ut-robotics/picr21-team-kurgimopeed/config/calibration_source_example.png

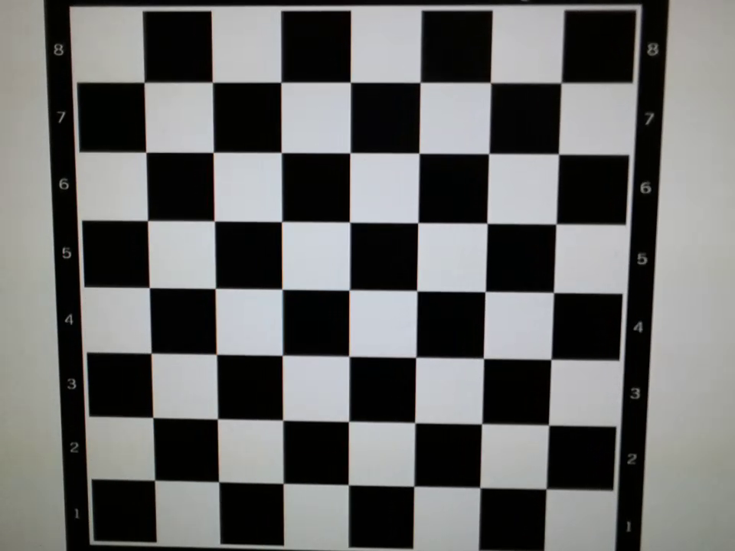
config/calibration_source_example.png
