ut-robotics/picr21-team-kurgimopeed/config/calibration_source.png

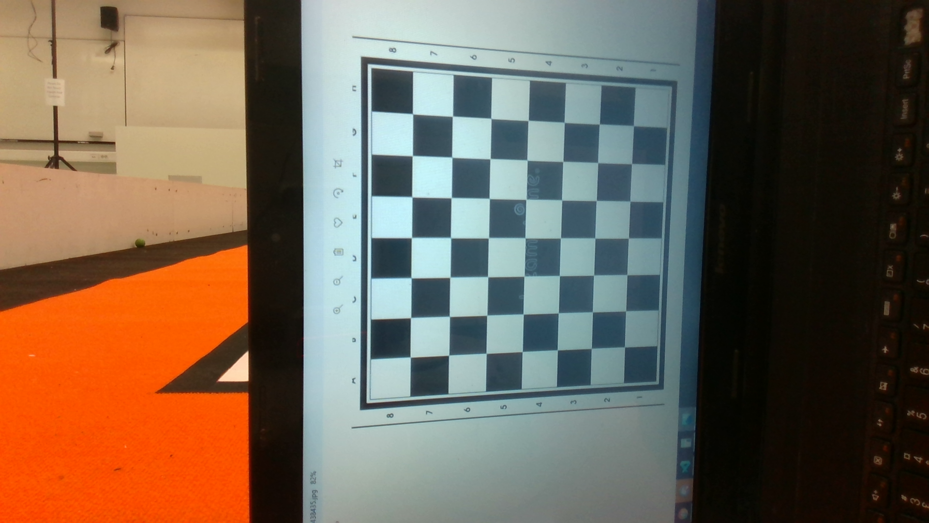
config/calibration_source.png
