ut-robotics/picr21-team-kurgimopeed/README.md

# picr21-team-kurgimopeed

## Usage

`sudo uvicorn app:app --port 5000` - start admin web view (in backend dir). port is configured in `/etc/nginx/nginx.conf`. root is required for led drivers and realsense (nice arch plugdev)
