ut-robotics/picr21-team-kurgimopeed/electronics/3dmodels/B1047AS-4R7N=P3.step

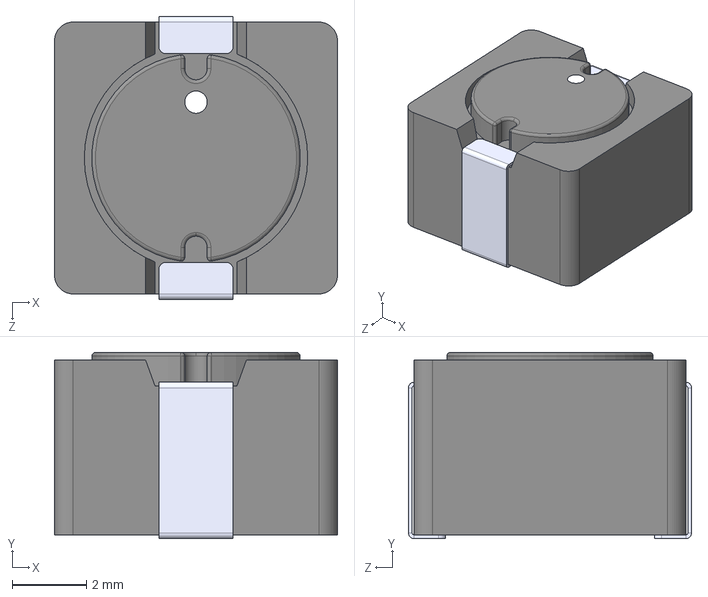
[picture p3: CAD file, 2021-11-22]
electronics/3dmodels/B1047AS-4R7N=P3.step
7.60 x 5.00 x 7.60 mm
