ut-robotics/picr21-team-kurgimopeed/electronics/graphics/pcb_inner.dxf

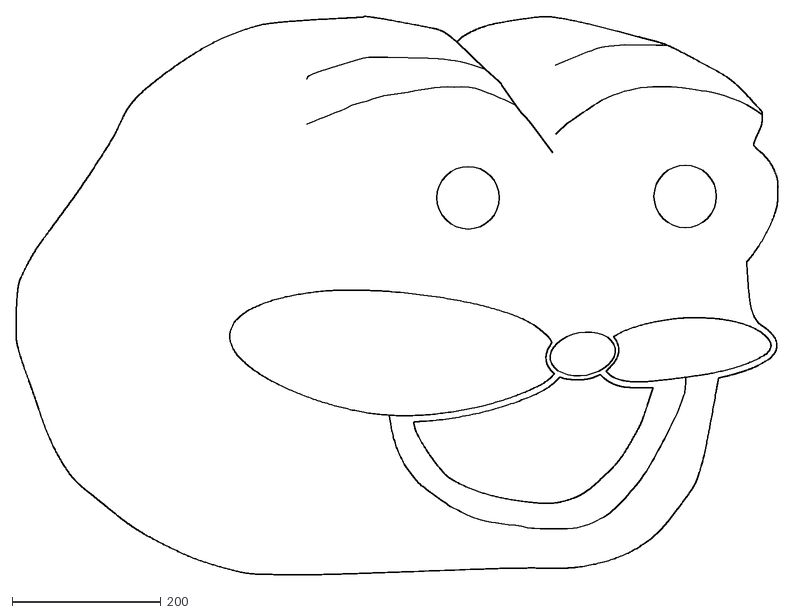
[picture p4: CAD file, 2021-11-01]
electronics/graphics/pcb_inner.dxf
1023.8 x 750.3
