ut-robotics/picr21-team-kurgimopeed/electronics/3dmodels/FTSH-105-XX-X-DV.step

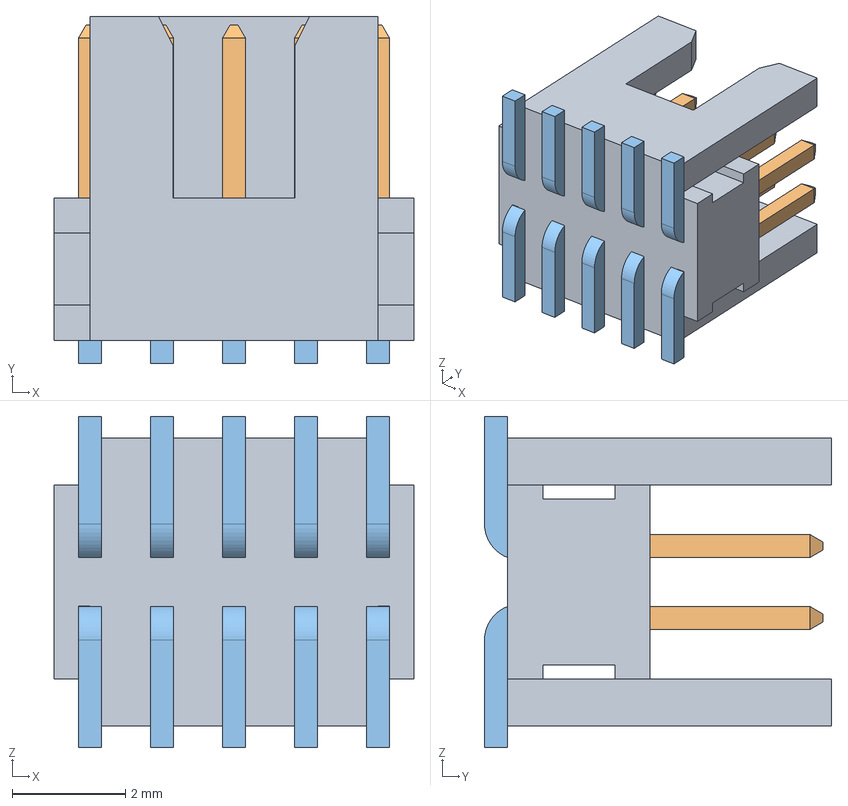
[picture p5: CAD file, 2021-11-01]
electronics/3dmodels/FTSH-105-XX-X-DV.step
6.35 x 6.12 x 5.84 mm
_FTSH-105-01-L-DV-K_body
_FTSH-105-01-L-DV-K_pins1
_FTSH-105-01-L-DV-K_pins2
