ut-robotics/picr21-team-kurgimopeed/electronics/graphics/pcb_outer.dxf

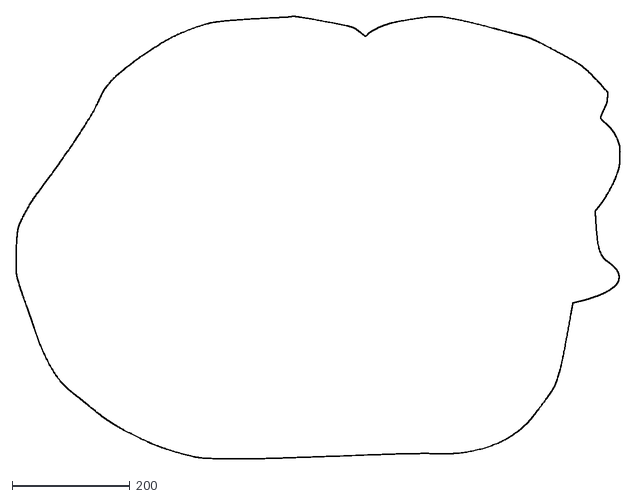
[picture p6: CAD file, 2021-11-01]
electronics/graphics/pcb_outer.dxf
1023.8 x 750.3
