ut-robotics/picr21-team-kurgimopeed/electronics/3dmodels/215079-4.step

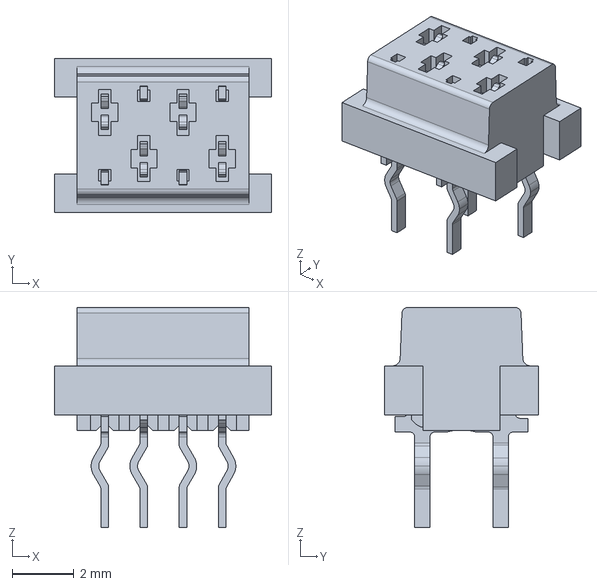
[picture p7: CAD file, 2021-11-01]
electronics/3dmodels/215079-4.step
7.04 x 5.00 x 7.15 mm
