ut-robotics/picr21-team-kurgimopeed/(threads)

Thread 1 (2021-09-27):

[Mechanics] - wrong material thickness

Akustav, 2021-09-27:
Material thickness for a 5mm PC sheet is actually 4.8mm

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

Closed 2021-10-02.

Thread 5 (2021-09-27):

[Mechanics] - pieces seem overdimensioned

Akustav, 2021-09-27:
The sidewalls seem unneeded large and don't appear to add anything. Maybe this part can be skipped?
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

Additionally the small ramps can maybe optimized? For example we can remove 2 of the 4 holes:
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

To get some additional support for the ramp, you can extend it below a little and make it rest on top of the chassis. Something like this:

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

Closed 2021-10-02.

Thread 7 (2021-10-07):

[Mechanics] - current feedrates too large

Akustav, 2021-10-07:
I think the current state of the mill does not allow for 1000mm/min feedrates. I would suggest at most 800mm. You can also reduce RPM to around 16000 in this case.

Closed 2021-10-10.

Thread 8 (2021-10-16):

Serial port is hardcoded

ReikoR, 2021-10-16:
https://github.com/ut-robotics/picr21-team-kurgimopeed/blob/785dc52e1931ac47d1d2bba7f9e51507c58a011b/backend/app.py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

Consider using [serial.tools.list_ports](https://pyserial.readthedocs.io/en/latest/tools.html#module-serial.tools.list_ports) to find correct USB device based on the port info values.

Thread 16 (2021-10-29):

[Mechanics] - Omniwheel roller extrusions should not cover the whole wheel

Akustav, 2021-10-29:
The extruded part locating the rollers should not touch anything but the internal part of the bearing. You would need to make a cut (red) and everything after that should be flat and further away from the rollers (blue)

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

Otherwise you can also use a conical extrusion similar to this:
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

Akustav, 2021-11-06:
Reopening. I would also remove these parts. They can touch the moving part of the bearing.
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

MattiasAvi, 2021-11-07:
Fixed This issue

Closed 2021-11-07.

Thread 18 (2021-10-29):

[Mechanics] - wheel patterning improvement

Akustav, 2021-10-29:
This is not an issue but more of an suggestion:

You do not need to pattern only sketches but can also pattern extrusions, cuts, chamfers or any other operations. This helps to simplify editing the model in certain situations.

MattiasAvi, 2021-10-30:
Very useful advice

Closed 2021-10-30.

Thread 20 (2021-10-29):

[Mechanics] - how the wheel should be placed in the robot

Akustav, 2021-10-29:
A question regarding how the wheel will fit into the whole assembly. Do you plan to cover the wheel?

This is important because currently rollers and bolts holding the wheel together can damage parts of the field (baskets) and opponents when they are grazed by the spinning wheel.

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

Closed 2021-10-30.

Thread 23 (2021-11-07):

Keep isolated parts completely separate

ReikoR, 2021-11-07:
Encoder connectors are placed on the drivers side, but are connected to MCU side. For better isolation (and signal integrity) the encoder signals should be kept on the MCU side.

All signals and power should be kept separate without any overlap and the gap between the isolated sides should be made larger.

Closed 2021-11-17.

Thread 24 (2021-11-07):

Use solid grounds on inner layers

ReikoR, 2021-11-07:
Try to use inner layers only for ground and outer layers for signals and power.

Recommended stackup:
1. Signals and power
2. GND (reference plane for layer 1)
3. GND (reference plane for layer 4)
4. Signals and power

Return current travels on the reference plane along the path of least impedance (as straight as possible in case of DC and under  the signal in case of higher speed signals).

When there are gaps in the reference plane the return current has to travel around the gaps. This will cause the electromagnetic fields to spread out and may cause signal integrity problems.

Some more info:
https://www.protoexpress.com/blog/current-return-path-signal-integrity/

Closed 2021-11-17.

Thread 25 (2021-11-07):

Use power inductor for switching regulator

ReikoR, 2021-11-07:
Switching regulator inductor (L1) should be rated for at least few amps and preferably with low DCR to reduce losses.

Closed 2021-11-17.

Thread 26 (2021-11-17):

Connect GND with vias close to the component

ReikoR, 2021-11-17:
When vias are farther away from the component, the current return path is farther away from the current supply path and larger current loop will create more crosstalk.

Component GND should be connected to the GND plane with vias as close as possible to GND pad. Multiple GND vias help to reduce the inductance. It's fine to put vias in pads when the components are hand soldered.

The return current should flow as close as possible to supply current.

GND copper zones on top and bottom layers are probably not needed at all, but might help with heat dissipations. GND vias in driver's GND pad help with heat dissipation.

Red lines show the current flow on the board right now and green lines show how it could be improved. Components should probably be moved a bit to help with routing and current loops.

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

ReikoR, 2021-11-19:
There are still several places where vias should be placed close to the components.

Some of them:
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

Closed 2021-11-21.

Thread 27 (2021-11-17):

Keep tracks above reference plane

ReikoR, 2021-11-17:
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

Tracks should be above the reference planes (GND in this case) to avoid electromagnetic fields from spreading out and causing crosstalk.

It would also be better if the tracks were not at the edge of the plane, but more inside the plane area.

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

Closed 2021-11-19.

Thread 28 (2021-11-17):

Follow switching regulator layout guidelines in the datasheet

ReikoR, 2021-11-17:
[TPS54227 datasheet](https://www.ti.com/lit/ds/symlink/tps54227.pdf)

For example SW node could be shorter and wider.

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

From datasheet:
> **10 Layout**
> **10.1 Layout Guidelines**
> 2\. Keep the SW node as physically small and short as possible to minimize parasitic capacitance and
inductance and to minimize radiated emissions. Kelvin connections should be brought from the output to the
feedback pin of the device
> 13\. PCB pattern for VIN, SW, and PGND should be as broad as possible.

Closed 2021-11-19.

Thread 29 (2021-11-17):

Add capacitor to NRST pin

ReikoR, 2021-11-17:
Recommendations from [STM32G441KB datasheet](https://www.st.com/resource/en/datasheet/stm32g441kb.pdf)
5.3.15 NRST pin characteristics
Figure 27. Recommended NRST pin protection
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

Switch on the drawing is optional.

> 1\. The reset network protects the device against parasitic resets.
> 3\. The external capacitor on NRST must be placed as close as possible to the device.

Closed 2021-11-19.

Thread 30 (2021-11-17):

Use larger annual ring for vias

ReikoR, 2021-11-17:
[JLCPCB capabilities](https://jlcpcb.com/capabilities/Capabilities) lists minimum annual ring as 0.13mm.

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

Currently vias are 0.3/0.5 mm size.

It's better to use 0.3/0.6 mm size.
0.2/0.45 mm is the smallest size that can be used if smaller vias are needed.

Closed 2021-11-19.

Thread 33 (2021-12-11):

Separate code more

ReikoR, 2021-12-11:
Right now `ImageProcess` class is inheriting `RSCamera` class and internally using `DrivingLogic` class instance. It would be better to clearly separate different classes so that they can function independently.

Generic example on how to keep different classes separate:
```python
class RobotController:
    def run(self):
        while not self.is_stopped:
            rgb_image = self.camera.get_rgb_image()
            objects = self.image_processor.find_objects(rgb_image) # returns balls, baskets
            motor_speeds = self.driving_logic.run_logic(objects)
            self.motor_driver.set_speeds(motor_speeds)
```

Above code is only partially based on existing code and omits a lot of functionality, but should give a general idea.

joshmmst, 2021-12-16:
hello
, we did some big changes in f58cd061d8bf84e7fb61010434024d1e80bd4f52. Everything should be O.K! Also added referee client.

joshmmst, 2021-12-16:
we kept motor driver on separate core with multiprocessing and referee server creates an event loop thread but rest is one thread pipeline. please do check RobotController class

ReikoR, 2021-12-17:
https://github.com/ut-robotics/picr21-team-kurgimopeed/blob/8249a71791fdd2d88afe97c632eb1babe7b56f4a/backend/src/RobotController.py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

https://github.com/ut-robotics/picr21-team-kurgimopeed/blob/8249a71791fdd2d88afe97c632eb1babe7b56f4a/backend/src/DrivingLogic.py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

You are also instantiating `RefereeClient` in `DrivingLogic`, but it's not used there.

jakoai, 2021-12-18:
Removen RefereeClient from DrivingLogic

Closed 2021-12-18.

Thread 34 (2021-12-13):

[Mechanics] - camera should point a little more down.

Akustav, 2021-12-13:
You would want an angle more like this:

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

The advantage here is that you see the ball until the last possible moment. Additionally you do not see spectators and whatever noise might come from there.

MattiasAvi, 2021-12-14:
Redesigned entire camera stand.

Closed 2021-12-14.

Thread 35 (2021-12-13):

[Mechanics] - thrower angle adjust could use previous iteration

Akustav, 2021-12-13:
I would change the thrower angle-adjust a little. I would make it so that the movement of the internal ramp is guided by a separate arm that extends from the center of the ramp (also the center of the motor), like this:

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

Such a system allows for a very smoothly moving internal ramp. Do you have a motor with a shaft?

Additionally the simplest angle adjust would be something like this:
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

Where the blue piece has a slot in it that goes into a pin that is attached to the moving ramp. If you move the servo up-down then the pin slides in this slot and allows the ramp to move either up or down.

Akustav, 2021-12-13:
You can also look at how the servo arm was used in conjunction with the blue piece.

Akustav, 2021-12-14:
Additionally it is unclear how stuff attaches to the servo since the servo horn is not in the model.

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

Akustav, 2021-12-21:
I would also beef up the arm. It should bend as little as possible while throwing:

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

MattiasAvi, 2021-12-21:
Made this part bulkier.

Akustav, 2021-12-21:
How do you plan to assemble it? I would make it so that you fasten the arm to the servo horn and then screw this assembly to the servo. Currently you need to do the final assembly with the servo attached that can make it more difficult.

I would have a central hole in the arm that lets you attach and remove the assembly simply.

MattiasAvi, 2021-12-21:
Thanks for this suggestion. It would have been quite annoying to assemble it. Made a hole in the center.

Closed 2021-12-22.

Thread 36 (2021-12-13):

[Mechanics] - move thrower into the robot

Akustav, 2021-12-13:
Currently the thower allows to pull a ball in from quite far off the sides:

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

This can create an issue with accuracy since it can be pulled through the thrower at an angle (red arrow).

You can do multiple things to mitigate it:
* move thrower inside so the sidewalls guide and center the ball
* Have a tight front end with a grabbing mechanism that centers the ball
* Have a slimmer front-end overall and hope programmers to a good job

MattiasAvi, 2021-12-14:
Moved robot thrower into the robot. Can't move any more because then PCB won't fit.

Closed 2021-12-14.

Thread 37 (2021-12-13):

[Mechanics] - how are internal ramp components attached?

Akustav, 2021-12-13:
How are these pieces attached to eachother?

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

MattiasAvi, 2021-12-14:
Stationary parts are attached with bolts and spacers. Do we have any long rods at least 65 mm of length in Delta? Preferably around 3 mm diameter.

Akustav, 2021-12-14:
I dont think we have such a rod. Why not use spacers instead? Would make assembly simpler and more robust. Additionally, why have the slot instead of 2 holes?

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

MattiasAvi, 2021-12-21:
I am going to use hex standoffs for spacing. Most spaces are multiples of 5.

Akustav, 2021-12-21:
OK

Closed 2021-12-21.

Thread 38 (2021-12-13):

[Mechanics] - button and power lead input out of spec

Akustav, 2021-12-13:
The power input for the computer and the switch ports are out of spec:

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

Their requirements can be found here: https://digilabor.ut.ee/index.php/Basketball_robot_mechanics_design#PC_power_adapter_socket

Additionally, your camera mount blocks the hole to the power socket.

MattiasAvi, 2021-12-14:
Switch and button holes should fit specifications. Left some room at shorter ends of switch to fit it in better.

Akustav, 2021-12-14:
You left space here? The Length is 32 mm
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

Closed 2021-12-21.

Thread 39 (2021-12-13):

[Mechanics] - what is the purpose of additional motor supports

Akustav, 2021-12-13:
What is the purpose of these components?

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

They can make assembly/disassembly difficult. How are these components attached to each other, i see a hole for both of them, is this used?

MattiasAvi, 2021-12-14:
Removed additional motor supports.

Closed 2021-12-14.

Thread 40 (2021-12-13):

[Mechanics] - no batteries on model

Akustav, 2021-12-13:
Power delivery components missing:
* Batteries
* Battery mounting mechanism
* Power cables from Batteries
* Cable holes for other components, like camera, mainboard

MattiasAvi, 2021-12-14:
Batteries are now on the robot and are attached with hook and loop fasteners.

Akustav, 2021-12-14:
Just a note, I think you attached the batteries bottom side up.

Closed 2021-12-14.

Thread 41 (2021-12-13):

[Mechanics] - RGB sensor of camera not in middle of robot

Akustav, 2021-12-13:
Is this designed as intended? Usually this makes programming more difficult since you now need to perspective correct the aim of the robot.

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

MattiasAvi, 2021-12-14:
Moved RGB sensor to the middle.

Akustav, 2021-12-14:
The FOV cone is currently not attached to the RGB sensor, FYI:

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

MattiasAvi, 2021-12-14:
Changed the origin of FOV to RGB camera

Closed 2021-12-21.

Thread 42 (2021-12-13):

[Mechanics] - ramps can bend under load

Akustav, 2021-12-13:
Nothing connects the internal ramp and it can bend:

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

A very similar issue can gappen with the bottom ramp parts. They can bend and change throwing characteristics:

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

I would connect them with a spacer at their ends. For the front one i would also make it a little shorter so it does not hit the ball before the motor.

Closed 2021-12-14.

Thread 43 (2021-12-14):

[Mechanics] - roller design questions

Akustav, 2021-12-14:
Why is the roller asymmetrical? Based on my experience it has no big benefit compared to a normal round one since the ball has a rubbery texture and will stick to most surfaces.

I would suggest something similar to this:

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

This has the advantage of being simple to attach and remove, the servo horn should not be too much in the way. Additionally I would suggest making the whole roller girthier, to increase its strength. You might ram things with it.

MattiasAvi, 2021-12-21:
I found asymmetrical design from one of the thrower design examples. But your idea seems much better and I made something similar.

Akustav, 2021-12-21:
It is true that I have experimented with the asymmetrical design. It did not bring any tangible benefits compared to a round and symmetrical design.

Closed 2021-12-21.

Thread 44 (2021-12-14):

[Mechanics] - servo mounting holes missing

Akustav, 2021-12-14:
The servos do not currently have mounting holes

MattiasAvi, 2021-12-21:
Now all servos have mounting holes. I am going to use M3 bolts to keep servos still. It will work if I don't use rubber things that come with Corona servos.

Closed 2021-12-21.

Thread 45 (2021-12-21):

[Mechanics] - no fasteners on the thower

Akustav, 2021-12-21:
I think you should add some fastening holes for the thrower into the bottom plate:

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

MattiasAvi, 2021-12-21:
Added 4 holes to fasten the thrower. Is it enough or should I find a way to fasten thrower to upper plate also_

Akustav, 2021-12-21:
I think it is fine

Closed 2021-12-21.

Thread 46 (2021-12-21):

[Mechanics] - electronics board interference with motor encoder caps

Akustav, 2021-12-21:
The encoder caps and the electronics board intersect:

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

MattiasAvi, 2021-12-21:
Draw more precise PCB shape and now there\s no interference.

Akustav, 2021-12-21:
I think you can not place the board on the bottom flat since it has headers that go through the board. Also if it lifts this might be an issue:
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

MattiasAvi, 2021-12-21:
This should not be an issue because our robot's encoders are stripped from the case and in reality are quite smaller.

Akustav, 2021-12-22:
If you say so

Closed 2021-12-22.

Thread 48 (2021-12-28):

[Mechanics] - weird order of operations

Akustav, 2021-12-28:
Why is the last operation a slot? It might rip the piece off the substrate since it is held on just by tabs:

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

Akustav, 2021-12-28:
Similar issue is with the 2DContour2, where too much is in one operation. It might mille the OD out first, then does the internal slot, that might break off:

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

MattiasAvi, 2021-12-28:
> Why is the last operation a slot? It might rip the piece off the substrate since it is held on just by tabs:
>
> 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

My bad. Forgot to move it up. Managed to merge this contour with another and use 3 mm mill.

MattiasAvi, 2021-12-28:
> Similar issue is with the 2DContour2, where too much is in one operation. It might mille the OD out first, then does the internal slot, that might break off:
>
> 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

By changing some parameters I was able to get rid of the center slot. Now there are no tabs needed.

Closed 2021-12-29.

Thread 49 (2021-12-28):

[Mechanics] - increase object spacing

Akustav, 2021-12-28:
Currently the spacing between objects in 3.5 mm. This makes some objects be too close together. I would increase it to around 5

MattiasAvi, 2021-12-28:
Increased all spacings to 5 mm.

Closed 2021-12-29.

Thread 50 (2021-12-29):

[Mechanics] - remove stock to leave

Akustav, 2021-12-29:
You currently set the stock to leave property in some of the operations. This has a side effect of things not fitting together since slots, for example, are 0.2mm tighter:

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

Akustav, 2021-12-29:
This might re-create the unneeded tab issue.

MattiasAvi, 2021-12-30:
Removed "Stock to leave" in tight spaces. Some warnings reappeared but shouldn't be a problem.

Closed 2021-12-31.

Thread 51 (2021-12-29):

[Mechanics] - issue with stock size

Akustav, 2021-12-29:
Currently you have 2 components that are 5 mm instead of 4.8mm. To minimize changes i would suggest changing the top offset to -0.2 mm:

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

MattiasAvi, 2021-12-30:
Changed width of those details and issue is fixed.

Closed 2021-12-31.
