ut-robotics/picr21-team-kurgimopeed/electronics/output/Electronics.pdf

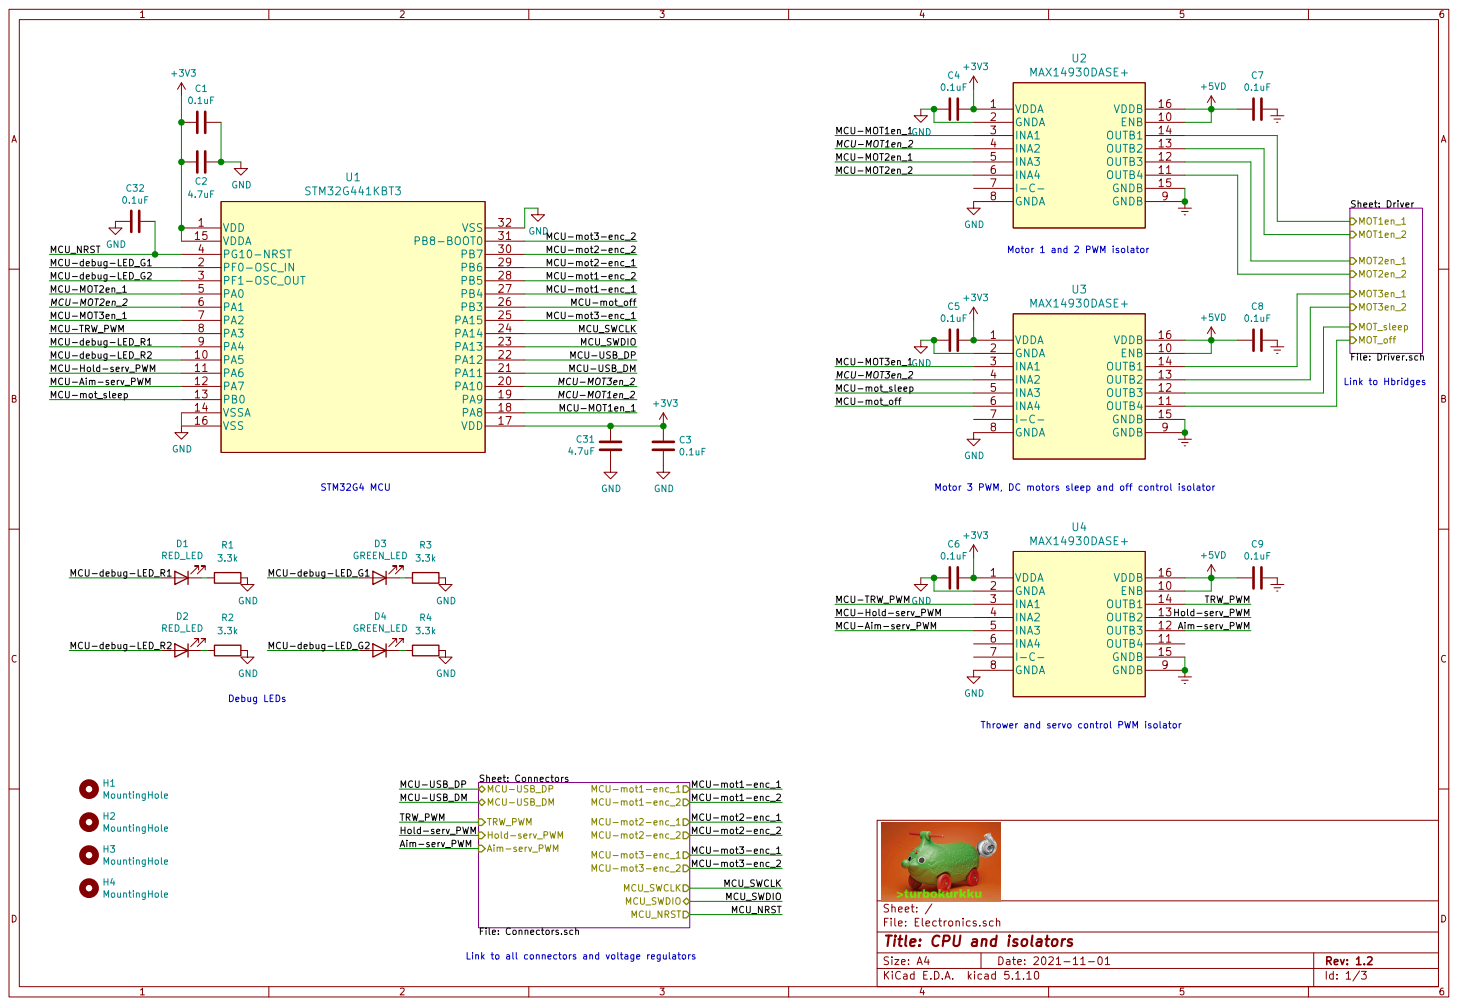
[picture p8: page 1]

MCU-debug-LED_R1 MCU-Hold-serv_PWM
MCU-Aim-serv_PWM

Link to Hbridges Thrower and servo control PWM isolator Motor 3 PWM, DC motors sleep and off control isolator Motor 1 and 2 PWM isolator

File: Electronics.sch Sheet: /
Id: 1/3 Title: CPU and isolators

Link to all connectors and voltage regulators

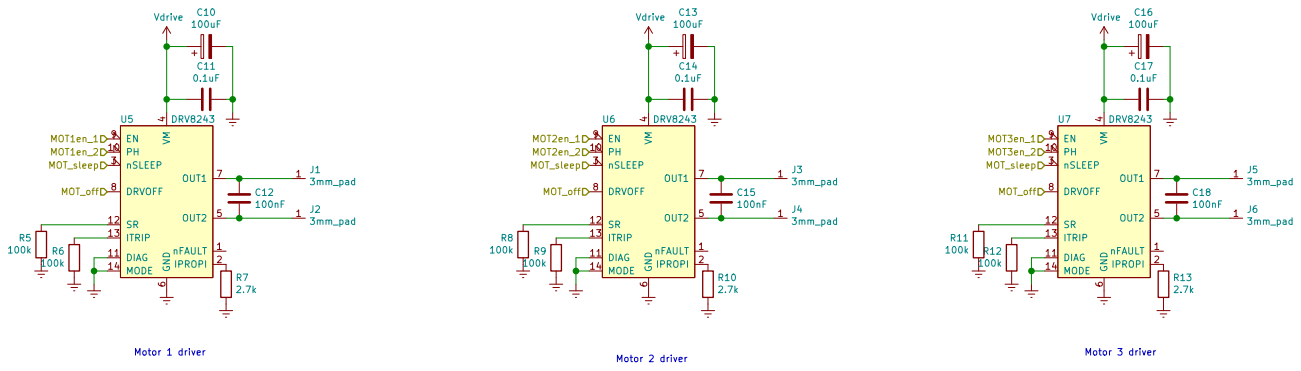
[picture p9: page 2]

6 OUT1 7 DRVOFF 8 EN 9 U7 DRV8243 Vdrive Vdrive C12

Id: 2/3 Title: Kurkkumopo HBridge driver File: Driver.sch Sheet: /Driver/

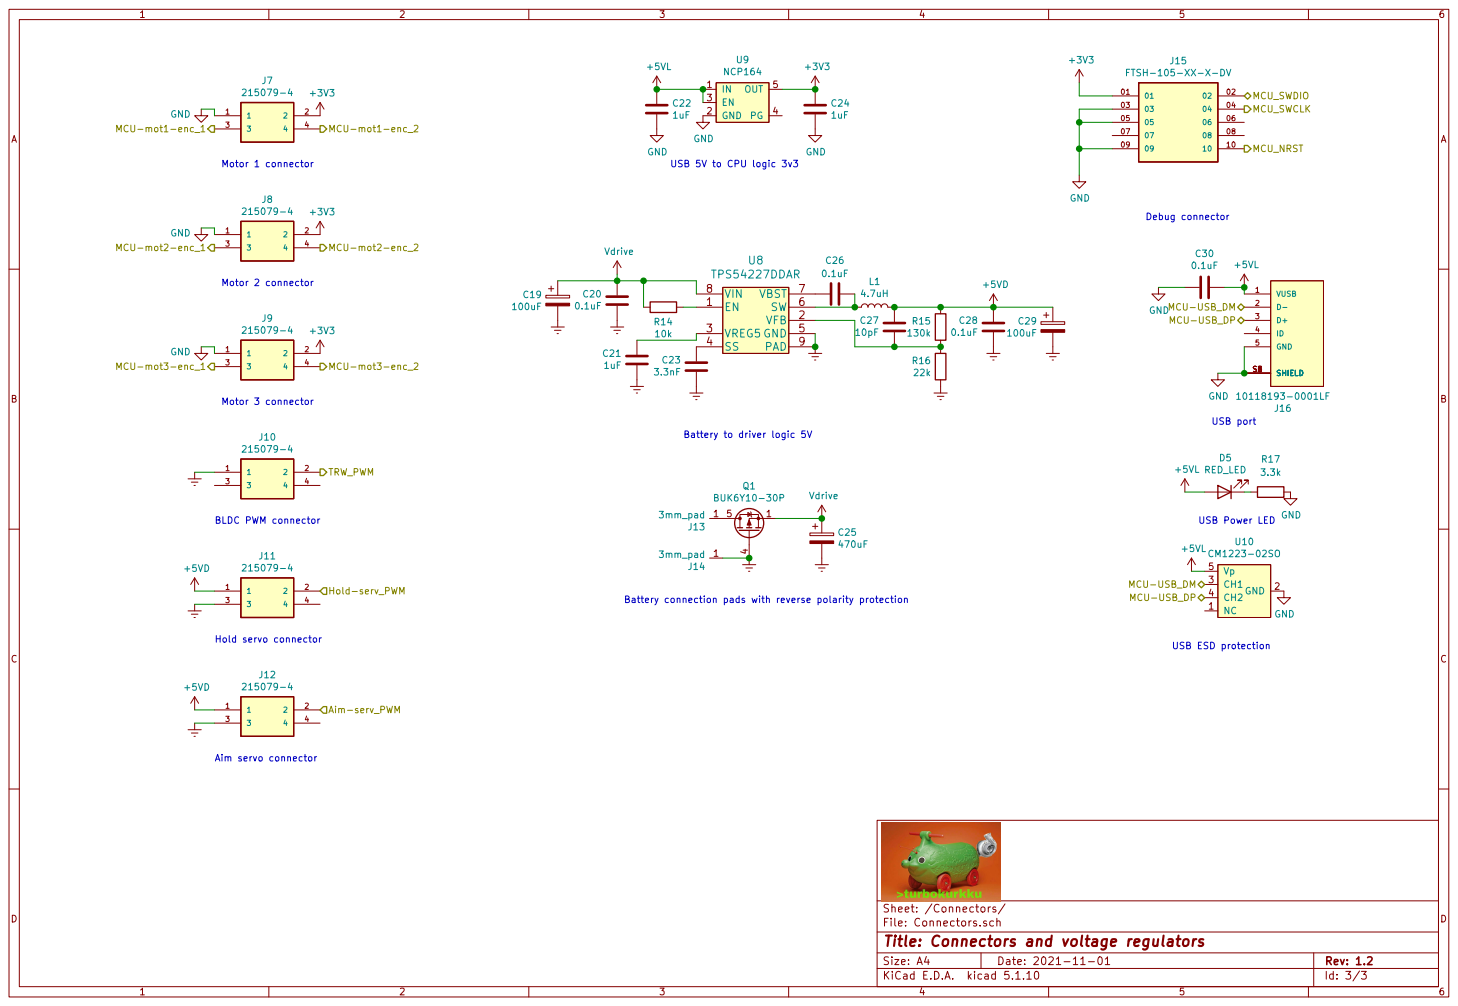
[picture p10: page 3]

Battery connection pads with reverse polarity protection

File: Connectors.sch Sheet: /Connectors/
Id: 3/3 Title: Connectors and voltage regulators
