ut-robotics/picr21-team-kurgimopeed/electronics/Electronics.kicad_pcb

## KiCad design electronics/Electronics.kicad_pcb (2021-11-22)

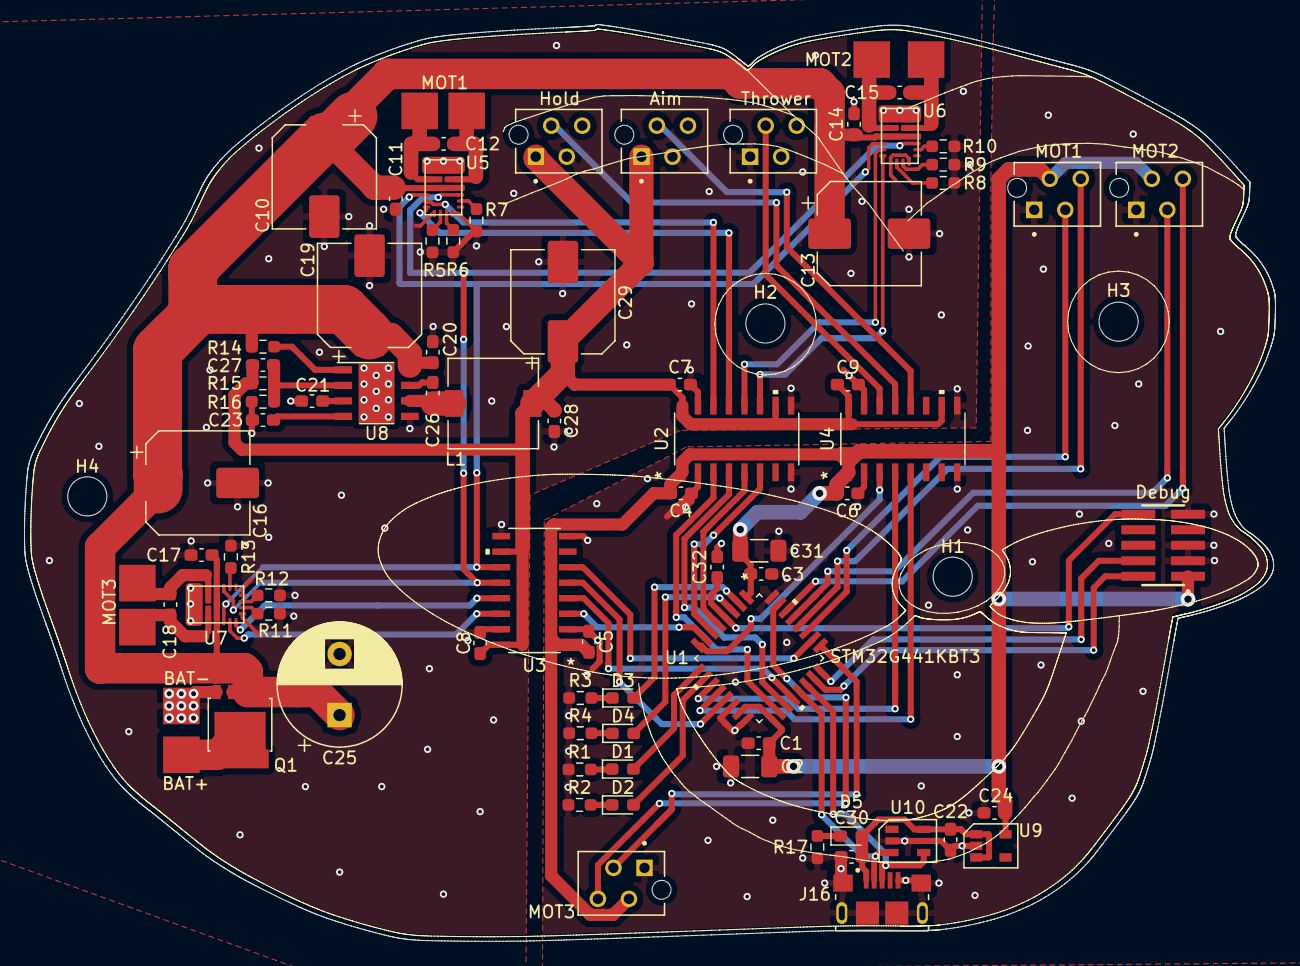
[picture p11: board Electronics.kicad_pcb from above]

Board: 4 copper layers, 102.4 x 75.0 mm, 86 parts (0 on the bottom side), 70 nets.

Parts:
Aim: 215079-4; TE_215079-4
BAT+: 3mm_pad
BAT-: 3mm_pad
C1, C3, C4, C5, C6, C7, C8, C9, C11, C14, C17, C20, C26, C28, C30, C32: 0.1uF; C_0603_1608Metric_Pad1.08x0.95mm_HandSolder
C2, C31: 4.7uF; C_1206_3216Metric_Pad1.33x1.80mm_HandSolder
C10, C13, C16, C19, C29: 100uF; CP_Elec_8x10
C12, C15, C18: 100nF; C_0603_1608Metric_Pad1.08x0.95mm_HandSolder
C21, C22, C24: 1uF; C_0603_1608Metric_Pad1.08x0.95mm_HandSolder
C23: 3.3nF; C_0603_1608Metric_Pad1.08x0.95mm_HandSolder
C25: 470uF; CP_Radial_D10.0mm_P5.00mm
C27: 10pF; C_0603_1608Metric_Pad1.08x0.95mm_HandSolder
D1, D2: RED_LED; LED_0603_1608Metric_Pad1.05x0.95mm_HandSolder
D3, D4: GREEN_LED; LED_0603_1608Metric_Pad1.05x0.95mm_HandSolder
D5: RED_LED; D_0603_1608Metric_Pad1.05x0.95mm_HandSolder
Debug: FTSH-105-XX-X-DV; SAMTEC_FTSH-105-XX-X-DV
H1, H2, H3, H4: MountingHole; MountingHole_3.2mm_M3
Hold: 215079-4; TE_215079-4
J2, J4, J5: 3mm_pad
J16: 10118193-0001LF; FCI_10118193-0001LF
L1: 4.7uH; L_7.3x7.3_H4.5
MOT1, MOT2, MOT3: 3mm_pad
MOT1#2, MOT2#2, MOT3#2: 215079-4; TE_215079-4
Q1: BUK6Y10-30P; LFPAK56
R1, R2, R3, R4, R17: 3.3k; R_0603_1608Metric_Pad0.98x0.95mm_HandSolder
R5, R6, R8, R9, R11, R12: 100k; R_0603_1608Metric_Pad0.98x0.95mm_HandSolder
R7, R10, R13: 2.7k; R_0603_1608Metric_Pad0.98x0.95mm_HandSolder
R14: 10k; R_0603_1608Metric_Pad0.98x0.95mm_HandSolder
R15: 130k; R_0603_1608Metric_Pad0.98x0.95mm_HandSolder
R16: 22k; R_0603_1608Metric_Pad0.98x0.95mm_HandSolder
Thrower: 215079-4; TE_215079-4
U1: STM32G441KBT3
U2, U3, U4: MAX14930DASE+; MAX14930DASE&plus_
U5, U6, U7: DRV8243; VQFN-HR-14
U8: TPS54227DDAR
U9: NCP164
U10: CM1223-02SO

Connections:
+3V3: C1.1, C2.1, C3.1, C4.2, C5.2, C6.2, C24.1, C31.2, Debug.01, MOT1#2.2, MOT2#2.2, MOT3#2.2, U1.1, U1.15, U1.17, U2.1, U3.1, U4.1, U9.5
+5VD: Aim.1, C7.1, C8.1, C9.1, C27.2, C28.2, C29.1, Hold.1, L1.2, R15.1, U2.10, U2.16, U3.10, U3.16, U4.10, U4.16
+5VL: C22.1, C30.2, D5.2, J16.1, U9.1, U9.3, U10.5
/Aim-serv_PWM: Aim.2, U4.12
/Driver/MOT1en_1: U2.14, U5.9
/Driver/MOT1en_2: U2.13, U5.10
/Driver/MOT2en_1: U2.12, U6.9
/Driver/MOT2en_2: U2.11, U6.10
/Driver/MOT3en_1: U3.14, U7.9
/Driver/MOT3en_2: U3.13, U7.10
/Driver/MOT_off: U3.11, U5.8, U6.8, U7.8
/Driver/MOT_sleep: U3.12, U5.3, U6.3, U7.3
/Hold-serv_PWM: Hold.2, U4.13
/MCU-Aim-serv_PWM: U1.12, U4.5
/MCU-Hold-serv_PWM: U1.11, U4.4
/MCU-MOT1en_1: U1.18, U2.3
/MCU-MOT1en_2: U1.19, U2.4
/MCU-MOT2en_1: U1.5, U2.5
/MCU-MOT2en_2: U1.6, U2.6
/MCU-MOT3en_1: U1.7, U3.3
/MCU-MOT3en_2: U1.20, U3.4
/MCU-TRW_PWM: U1.8, U4.3
/MCU-USB_DM: J16.2, U1.21, U10.3
/MCU-USB_DP: J16.3, U1.22, U10.4
/MCU-debug-LED_G1: D3.2, U1.2
/MCU-debug-LED_G2: D4.2, U1.3
/MCU-debug-LED_R1: D1.2, U1.9
/MCU-debug-LED_R2: D2.2, U1.10
/MCU-mot1-enc_1: MOT1#2.3, U1.27
/MCU-mot1-enc_2: MOT1#2.4, U1.28
/MCU-mot2-enc_1: MOT2#2.3, U1.29
/MCU-mot2-enc_2: MOT2#2.4, U1.30
/MCU-mot3-enc_1: MOT3#2.3, U1.25
/MCU-mot3-enc_2: MOT3#2.4, U1.31
/MCU-mot_off: U1.26, U3.6
/MCU-mot_sleep: U1.13, U3.5
/MCU_NRST: C32.1, Debug.10, U1.4
/MCU_SWCLK: Debug.04, U1.24
/MCU_SWDIO: Debug.02, U1.23
/TRW_PWM: Thrower.2, U4.14
Earth: Aim.3, BAT-.1, C7.2, C8.2, C9.2, C10.2, C11.1, C13.2, C14.1, C16.2, C17.1, C19.2, C20.1, C21.1, C23.1, C25.2, C28.1, C29.2, Hold.3, Q1.4, R5.1, R6.1, R7.1, R8.1, R9.1, R10.1, R11.1, R12.1, R13.1, R16.2, Thrower.1, U2.9, U2.15, U3.9, U3.15, U4.9, U4.15, U5.6, U5.11, U5.14, U6.6, U6.11, U6.14, U7.6, U7.11, U7.14, U8.5, U8.9
GND: C1.2, C2.2, C3.2, C4.1, C5.1, C6.1, C22.2, C24.2, C30.1, C31.1, C32.2, Debug.03, Debug.05, Debug.09, J16.5, J16.S1, J16.S2, J16.S3, J16.S4, J16.S5, J16.S6, MOT1#2.1, MOT2#2.1, MOT3#2.1, R1.1, R2.1, R3.1, R4.1, R17.1, U1.14, U1.16, U1.32, U2.2, U2.8, U3.2, U3.8, U4.2, U4.8, U9.2, U10.2
unnamed: C12.1, MOT1.1, U5.7
unnamed: C12.2, J2.1, U5.5
unnamed: C15.1, MOT2.1, U6.7
unnamed: C15.2, J4.1, U6.5
unnamed: C18.1, J5.1, U7.7
unnamed: C18.2, MOT3.1, U7.5
unnamed: C21.2, U8.3
unnamed: C23.2, U8.4
unnamed: C26.1, U8.7
unnamed: C26.2, L1.1, U8.6
unnamed: C27.1, R15.2, R16.1, U8.2
unnamed: D1.1, R1.2
unnamed: D2.1, R2.2
unnamed: D3.1, R3.2
unnamed: D4.1, R4.2
unnamed: D5.1, R17.2
unnamed: BAT+.1, Q1.5
unnamed: R5.2, U5.12
unnamed: R6.2, U5.13
unnamed: R7.2, U5.2
unnamed: R8.2, U6.12
unnamed: R9.2, U6.13
unnamed: R10.2, U6.2
unnamed: R11.2, U7.12
unnamed: R12.2, U7.13
unnamed: R13.2, U7.2
unnamed: R14.2, U8.1
Vdrive: C10.1, C11.2, C13.1, C14.2, C16.1, C17.2, C19.1, C20.2, C25.1, Q1.1, Q1.2, Q1.3, R14.1, U5.4, U6.4, U7.4, U8.8
