ut-robotics/picr21-team-kurgimopeed/firmware/Core/Src/main.c

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
/* Includes ------------------------------------------------------------------*/
#include "main.h"
#include "usb_device.h"

/* USER CODE BEGIN Includes */
#include "usbd_cdc_if.h"
/* USER CODE END Includes */

ADC_HandleTypeDef hadc1;
DMA_HandleTypeDef hdma_adc1;

CRC_HandleTypeDef hcrc;

RTC_HandleTypeDef hrtc;

TIM_HandleTypeDef htim1;
TIM_HandleTypeDef htim2;
TIM_HandleTypeDef htim3;
TIM_HandleTypeDef htim4;
TIM_HandleTypeDef htim6;
TIM_HandleTypeDef htim8;
TIM_HandleTypeDef htim15;
TIM_HandleTypeDef htim16;
TIM_HandleTypeDef htim17;

void SystemClock_Config(void);
static void MX_GPIO_Init(void);
static void MX_TIM1_Init(void);
static void MX_RTC_Init(void);
static void MX_TIM2_Init(void);
static void MX_TIM3_Init(void);
static void MX_TIM8_Init(void);
static void MX_TIM17_Init(void);
static void MX_TIM16_Init(void);
static void MX_TIM4_Init(void);
static void MX_TIM15_Init(void);
static void MX_DMA_Init(void);
static void MX_ADC1_Init(void);
static void MX_CRC_Init(void);
static void MX_TIM6_Init(void);
/* USER CODE BEGIN 0 */


/**
 * Motor status struct
 */
typedef struct {
  float target_speed;  ///< Current motor target speed
  uint8_t forward;        ///< 0 means backwards, 1 is forwards
  float integral;       ///< Integral value for PID
  int16_t pos;            ///< Current encoder position
  float flat_const;       ///< PID constant for current error
  float int_const;        ///< PID constant for integral
  float deriv_const;      ///< PID constant for derivative
} mot_status_t;


/**
 * List of possible errors that are sent to master
 */
typedef enum {
  MCU_OK,                 ///< Everythings good
  MCU_USB_BAD_DATA,       ///< Got bad data from USB, eg. CRC mismatch
  MCU_SPEED_TOO_HIGH      ///< Got too high speed from master
} mcu_errors_t;


/**
 * Incoming command struct
 */
typedef struct {
  int16_t speeds[3];      ///< Incoming target speed array
  uint16_t thrower_speed; ///< Incoming thrower target speed
  uint16_t aim_pwm;       ///< Aim servo PWM value
  uint16_t hold_pwm;      ///< Hold servo PWM value
  uint16_t command;       ///< Other commands eg. 3 LSB direct motors
  uint16_t crc;           ///< CRC for error detection
} ser_command_t;


/**
 * Serial feedback struct
 */
typedef struct {
  mcu_errors_t error;     ///< If and what error has occured
  int32_t enc_data[3];    ///< Encoder data
  uint16_t varia;         ///< Other variable data eh. ball was detected
  uint16_t crc;           ///< CRC for error detection
} ser_feedback_t;

ser_command_t cmd_in = {0};
mot_status_t motor_status[3] = {0};
__IO uint8_t is_command_received = 0;
mcu_errors_t mcu_error;
uint8_t feedback_needed = 0;
ser_feedback_t ser_feedback = {0};


/**
 * Mapping function to get a value from one range to other
 */
uint16_t map(float input, int32_t f_l, int32_t f_h, int32_t t_l, int32_t t_h) {
  return ((input - f_l) * (t_h - t_l)) / ((f_h - f_l) + t_l);
}

float f_map(uint16_t input, int32_t f_l, int32_t f_h, int32_t t_l, int32_t t_h) {
  return (float) ((float) (input - f_l) * (t_h - t_l)) / ((f_h - f_l) + t_l);
}

/**
 * Function that gets called when new USB data arrives
 *
 * Updates cmd_in structure and so updates target speeds
 */
void CDC_On_Receive(uint8_t* buffer, uint32_t* length) {
  is_command_received = 1;
  mcu_error = MCU_USB_BAD_DATA;
  if (*length == sizeof(ser_command_t)) {
	  ser_command_t ser_data;
	  memcpy(&ser_data, buffer, sizeof(ser_command_t));
	  uint16_t got_crc = ser_data.crc;
	  ser_data.crc = 0;
	  uint16_t calculated_crc = HAL_CRC_Calculate(&hcrc, (uint32_t *) &ser_data, (*length));
    if(got_crc == calculated_crc) {
    	memcpy(&cmd_in, buffer, sizeof(ser_command_t));
    	cmd_in.thrower_speed = map(cmd_in.thrower_speed, 0, 65535, 3120, 6240);
    	mcu_error = MCU_OK;
    }
  }
}


/**
 * Fills feedback struct to be sent to master
 */
void generate_feedback() {
  ser_feedback.error = mcu_error;
  ser_feedback.enc_data[0] = motor_status[0].pos;
  ser_feedback.enc_data[1] = motor_status[1].pos;
  ser_feedback.enc_data[2] = motor_status[2].pos;
  ser_feedback.crc = 0;
  ser_feedback.crc = HAL_CRC_Calculate(&hcrc, (uint32_t *) &ser_feedback, sizeof(ser_feedback_t));
}


/**
 * Initialises HAL TIM PWM and
 * sets their max limits to 0xFFFF* to make sure it will not get counted to 0xFFFFFFFF
 */
void init_pwm() {
  TIM1->ARR = 0xFFFF;
  TIM2->ARR = 0xFFFF;

  // Motor 1
  HAL_TIM_PWM_Start(&htim1, TIM_CHANNEL_1);
  HAL_TIM_PWM_Start(&htim1, TIM_CHANNEL_2);

  // Motor 2
  HAL_TIM_PWM_Start(&htim2, TIM_CHANNEL_1);
  HAL_TIM_PWM_Start(&htim2, TIM_CHANNEL_2);

  // Motor 3
  HAL_TIM_PWM_Start(&htim2, TIM_CHANNEL_3);
  HAL_TIM_PWM_Start(&htim2, TIM_CHANNEL_4);

  // Thrower
  HAL_TIM_PWM_Start(&htim15, TIM_CHANNEL_2);

  // Hold servo
  HAL_TIM_PWM_Start(&htim16, TIM_CHANNEL_1);

  // Aim servo
  HAL_TIM_PWM_Start(&htim17, TIM_CHANNEL_1);
}


/**
 * Function for manually setting PID constants for each motor
 */
void set_pid_constants() {
	motor_status[0].flat_const = 5;
	motor_status[0].int_const = 0.1;
	motor_status[0].deriv_const = 0;

	motor_status[1].flat_const = 5;
	motor_status[1].int_const = 0.1;
	motor_status[1].deriv_const = 0;

	motor_status[2].flat_const = 5;
	motor_status[2].int_const = 0.1;
	motor_status[2].deriv_const = 0;
}


/**
 * Wakes drivers up by sending an nSleep pulse
 */
void wake_drivers_up() {
    HAL_GPIO_WritePin(GPIOB, MOT_SLEEP_Pin, GPIO_PIN_RESET);
    for(uint16_t i = 0; i < 350; i++) __asm("nop");
	HAL_GPIO_WritePin(GPIOB, MOT_SLEEP_Pin, GPIO_PIN_SET);
	for(uint16_t i = 0; i < 10; i++) __asm("nop");
}


/**
 * Starts TIM encoders
 */
void start_encoders() {
  HAL_TIM_Encoder_Start(&htim3, TIM_CHANNEL_1 | TIM_CHANNEL_2);
  HAL_TIM_Encoder_Start(&htim4, TIM_CHANNEL_1 | TIM_CHANNEL_2);
  HAL_TIM_Encoder_Start(&htim8, TIM_CHANNEL_1 | TIM_CHANNEL_2);
}


void arm_thrower() {
	TIM15->CCR2 = 3120;
	HAL_Delay(500);
	TIM15->CCR2 = 2000;
	HAL_Delay(1500);
	TIM15->CCR2 = 3120;
}


/**
 * Called when new command arrives from master
 *
 * Reads the command byte and updates target speed
 */
void update_motor_status() {
  for(uint8_t i = 0; i < 3; i++) {
	if(cmd_in.command & (1 << i))
	  motor_status[i].forward = 1;
	else
	  motor_status[i].forward = 0;
	motor_status[i].target_speed = f_map(cmd_in.speeds[i], 0, 65535, 0, 106);
  }
  if(cmd_in.command & (1 << 4)) {
	arm_thrower();
	wake_drivers_up();
  }
  TIM15->CCR2 = cmd_in.thrower_speed + 3120;
  TIM16->CCR1 = cmd_in.hold_pwm;
  TIM17->CCR1 = cmd_in.aim_pwm;
}


/**
 * Calculates PWM speed that will be sent to the motors
 * Takes motor id as input through which it can calculate error and get needed data
 *
 * Returns a value between 0 and 2^16 - 1
 */
int16_t calc_pwm(uint8_t mot_id) {
  int16_t change;
  float pid_speed, error;

  // Calculate change and update corresponding motor position
  switch(mot_id) {
    case(0):
	  change = TIM3->CNT - motor_status[0].pos;
      motor_status[0].pos = TIM3->CNT;
      break;
    case(1):
      change = TIM4->CNT - motor_status[1].pos;
      motor_status[1].pos = TIM4->CNT;
      break;
    case(2):
      change = TIM8->CNT - motor_status[2].pos;
      motor_status[2].pos = TIM8->CNT;
  }
  if(change < 0)
	change *= -1;
  if(change > 106)
	change = 106;

  // Calculate error and PID
  error = motor_status[mot_id].target_speed - change;
  motor_status[mot_id].integral += error;
  pid_speed = error * motor_status[mot_id].flat_const +
		  motor_status[mot_id].integral * motor_status[mot_id].int_const;

  // Keep the motor speed within limits
  if(pid_speed > 106)
	pid_speed = 106;
  else if(pid_speed < 0)
	pid_speed = 0;

  // Map the encoder speed to PWM speed and return it
  return map(pid_speed, 0, 106, 0, 65535);
}

/**
 * Function that gets called periodically by timer interrupt
 *
 * Used for calculating and correcting PWM values for each motor
 */
void HAL_TIM_PeriodElapsedCallback(TIM_HandleTypeDef *htim) {

  HAL_GPIO_TogglePin(GPIOF, GREEN_DBG_LED_1_Pin);
  TIM1->CCR1 = calc_pwm(0);
  TIM2->CCR1 = calc_pwm(1);
  TIM2->CCR3 = calc_pwm(2);

  if(!motor_status[0].forward) {
	TIM1->CCR2 = 0;
  } else {
	TIM1->CCR2 = 65535;
	  }
  if(!motor_status[1].forward) {
	TIM2->CCR2 = 0;
  } else {
	TIM2->CCR2 = 65535;
  }
  if(!motor_status[2].forward) {
	TIM2->CCR4 = 0;
  } else {
	TIM2->CCR4 = 65535;
  }
}


/*
 * EXTI callback for ball detector
 */
void HAL_GPIO_EXTI_Callback(uint16_t GPIO_Pin) {
  if(GPIO_Pin == GPIO_PIN_5) {
	HAL_GPIO_TogglePin(RED_DBG_LED_1_GPIO_Port, RED_DBG_LED_1_Pin);
	ser_feedback.varia = 0xFFFF;
	feedback_needed = 1;
  }
}


/* USER CODE END 0 */

/**
  * @brief  The application entry point.
  * @retval int
  */
int main(void)
{
  /* MCU Configuration--------------------------------------------------------*/

  /* Reset of all peripherals, Initializes the Flash interface and the Systick. */
  HAL_Init();

  /* Configure the system clock */
  SystemClock_Config();

  /* Initialize all configured peripherals */
  MX_GPIO_Init();
  MX_TIM1_Init();
  MX_RTC_Init();
  MX_TIM2_Init();
  MX_TIM3_Init();
  MX_TIM8_Init();
  MX_TIM17_Init();
  MX_TIM16_Init();
  MX_TIM4_Init();
  MX_TIM15_Init();
  MX_USB_Device_Init();
  MX_DMA_Init();
  MX_ADC1_Init();
  MX_CRC_Init();
  MX_TIM6_Init();
  /* USER CODE BEGIN 2 */
  HAL_TIM_Base_Start_IT(&htim6);
  HAL_GPIO_WritePin(GPIOB, MOT_SLEEP_Pin, GPIO_PIN_SET);
  set_pid_constants();
  HAL_Delay(100);
  start_encoders();
  wake_drivers_up();
  init_pwm();
  TIM15->CCR2 = 3120;

  /* USER CODE END 2 */

  /* Infinite loop */
  /* USER CODE BEGIN WHILE */
  while (1) {
	if(is_command_received) {
	  is_command_received = 0;
	  if(!mcu_error) {
		HAL_GPIO_TogglePin(GPIOF, GREEN_DBG_LED_2_Pin);
		update_motor_status();
	  }
	  feedback_needed = 1;
	}
	if(feedback_needed) {
      generate_feedback();
	  CDC_Transmit_FS((uint8_t*) &ser_feedback, sizeof(ser_feedback_t));
	  feedback_needed = 0;
	  ser_feedback.varia = 0;
	}
    /* USER CODE END WHILE */

    /* USER CODE BEGIN 3 */
  }
  /* USER CODE END 3 */
}

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
