ut-robotics/picr21-team-kurgimopeed/firmware/firmware.ioc

Mcu.UserName=STM32G441KBTx
PA0.GPIO_Label=MOT2-PWM_1
PA0.Signal=S_TIM2_CH1
PA1.GPIO_Label=MOT2-PWM_2
PA1.Signal=S_TIM2_CH2
PA10.GPIO_Label=MOT3-PWM_2
PA10.Signal=S_TIM2_CH4
PA11.Signal=USB_DM
PA12.Signal=USB_DP
PA13.Signal=SYS_JTMS-SWDIO
PA14.Signal=SYS_JTCK-SWCLK
PA15.GPIO_Label=MOT3-ENC_1
PA15.Signal=S_TIM8_CH1
PA2.GPIO_Label=MOT3-PWM_1
PA2.Signal=S_TIM2_CH3
PA3.GPIO_Label=TRW-PWM_1
PA3.Signal=S_TIM15_CH2
PA4.GPIO_Label=RED-DBG-LED_1
PA4.Signal=GPIO_Output
PA5.GPIO_Label=BALL_FINDER
PA5.Signal=GPXTI5
PA6.GPIO_Label=HOLD-servo_PWM
PA6.Signal=S_TIM16_CH1
PA7.GPIO_Label=AIM-servo_PWM
PA7.Signal=S_TIM17_CH1
PA8.GPIO_Label=MOT1-PWM_1
PA8.Signal=S_TIM1_CH1
PA9.GPIO_Label=MOT1-PWM_2
PA9.Signal=S_TIM1_CH2
PB0.GPIO_Label=MOT_SLEEP
PB0.Signal=GPIO_Output
PB3.GPIO_Label=MOT_OFF
PB3.Signal=GPIO_Output
PB4.GPIO_Label=MOT1-ENC_1
PB4.Signal=S_TIM3_CH1
PB5.GPIO_Label=MOT1-ENC_2
PB5.Signal=S_TIM3_CH2
PB6.GPIO_Label=MOT2-ENC_1
PB6.Signal=S_TIM4_CH1
PB7.GPIO_Label=MOT2-ENC_2
PB7.Signal=S_TIM4_CH2
PB8-BOOT0.GPIO_Label=MOT3-ENC_2
PB8-BOOT0.Signal=S_TIM8_CH2
PF0-OSC_IN.GPIO_Label=GREEN-DBG-LED_1
PF0-OSC_IN.Signal=GPIO_Output
PF1-OSC_OUT.GPIO_Label=GREEN-DBG-LED_2
PF1-OSC_OUT.Signal=GPIO_Output
