ut-robotics/picr21-team-kurgimopeed/firmware/Core/Inc/main.h

#define GREEN_DBG_LED_1_Pin GPIO_PIN_0
#define GREEN_DBG_LED_1_GPIO_Port GPIOF
#define GREEN_DBG_LED_2_Pin GPIO_PIN_1
#define GREEN_DBG_LED_2_GPIO_Port GPIOF
#define MOT2_PWM_1_Pin GPIO_PIN_0
#define MOT2_PWM_1_GPIO_Port GPIOA
#define MOT2_PWM_2_Pin GPIO_PIN_1
#define MOT2_PWM_2_GPIO_Port GPIOA
#define MOT3_PWM_1_Pin GPIO_PIN_2
#define MOT3_PWM_1_GPIO_Port GPIOA
#define TRW_PWM_1_Pin GPIO_PIN_3
#define TRW_PWM_1_GPIO_Port GPIOA
#define RED_DBG_LED_1_Pin GPIO_PIN_4
#define RED_DBG_LED_1_GPIO_Port GPIOA
#define BALL_FINDER_Pin GPIO_PIN_5
#define BALL_FINDER_GPIO_Port GPIOA
#define BALL_FINDER_EXTI_IRQn EXTI9_5_IRQn
#define HOLD_servo_PWM_Pin GPIO_PIN_6
#define HOLD_servo_PWM_GPIO_Port GPIOA
#define AIM_servo_PWM_Pin GPIO_PIN_7
#define AIM_servo_PWM_GPIO_Port GPIOA
#define MOT_SLEEP_Pin GPIO_PIN_0
#define MOT_SLEEP_GPIO_Port GPIOB
#define MOT1_PWM_1_Pin GPIO_PIN_8
#define MOT1_PWM_1_GPIO_Port GPIOA
#define MOT1_PWM_2_Pin GPIO_PIN_9
#define MOT1_PWM_2_GPIO_Port GPIOA
#define MOT3_PWM_2_Pin GPIO_PIN_10
#define MOT3_PWM_2_GPIO_Port GPIOA
#define MOT3_ENC_1_Pin GPIO_PIN_15
#define MOT3_ENC_1_GPIO_Port GPIOA
#define MOT_OFF_Pin GPIO_PIN_3
#define MOT_OFF_GPIO_Port GPIOB
#define MOT1_ENC_1_Pin GPIO_PIN_4
#define MOT1_ENC_1_GPIO_Port GPIOB
#define MOT1_ENC_2_Pin GPIO_PIN_5
#define MOT1_ENC_2_GPIO_Port GPIOB
#define MOT2_ENC_1_Pin GPIO_PIN_6
#define MOT2_ENC_1_GPIO_Port GPIOB
#define MOT2_ENC_2_Pin GPIO_PIN_7
#define MOT2_ENC_2_GPIO_Port GPIOB
#define MOT3_ENC_2_Pin GPIO_PIN_8
#define MOT3_ENC_2_GPIO_Port GPIOB
