ut-robotics/picr21-team-kurgimopeed/backend/src/GoalDetector.py

import cv2
import numpy as np
from src.Tools import calculateCoordinate, depth_distance

class GoalDetector():
    ID_PINK = 0
    ID_BLUE = 1
    def __init__(self):
        self.pink_lower = np.array([0, 0, 0])
        self.pink_upper = np.array([0, 0, 0])
        self.blue_lower = np.array([0, 0, 0])
        self.blue_upper = np.array([0, 0, 0])

        self.pink_debug_mask = None
        self.blue_debug_mask = None

        self.pink_location = None
        self.blue_location = None

        self.goal_hack_const = np.array([0, 0, 0])
        self.goal_min_area = 750

    def set_threshold(self, threshold_values, id=ID_PINK):
        if id is self.ID_PINK:
            lower = threshold_values["pink_goal"][:3]
            upper = threshold_values["pink_goal"][3:]
            self.pink_lower = np.array(lower)
            self.pink_upper = np.array(upper)
        if id is self.ID_BLUE:
            lower = threshold_values["blue_goal"][:3]
            upper = threshold_values["blue_goal"][3:]
            self.blue_lower = np.array(lower)
            self.blue_upper = np.array(upper)

    # should ball tracking be done here?
    def get_mask(self, hsv_frame, id=ID_PINK):
        if id is self.ID_PINK:
            mask = cv2.inRange(hsv_frame, self.pink_lower, self.pink_upper)
        if id is self.ID_BLUE:
            mask = cv2.inRange(hsv_frame, self.blue_lower, self.blue_upper)

        kernel = np.ones((5,5),np.uint8)
        mask = cv2.morphologyEx(mask, cv2.MORPH_OPEN, kernel)
        return mask

    def get_debug_mask(self, id=ID_PINK):
        if (id == self.ID_PINK):
            return self.pink_debug_mask
        if (id == self.ID_BLUE):
            return self.blue_debug_mask

    def getLocations(self, hsv_frame, depth_frame, id=ID_PINK):
        mask = self.get_mask(hsv_frame, id)

        if (id == self.ID_PINK):
            self.pink_debug_mask = np.zeros(mask.shape, dtype=np.uint8)
        if (id == self.ID_BLUE):
            self.blue_debug_mask = np.zeros(mask.shape, dtype=np.uint8)

        contours, _ = cv2.findContours(image=mask, mode=cv2.RETR_TREE, method=cv2.CHAIN_APPROX_NONE)
        
        goal = None
        for cnt in contours:
            rect = cv2.minAreaRect(cnt)
            _, size, _ = rect
            area_size = size[0]*size[1]
            g_area_size = 0
            if goal is not None:
                _, g_size, _ = goal
                g_area_size = g_size[0]*g_size[1]
                
            if g_area_size < area_size:
                if (area_size > self.goal_min_area):
                    goal = rect


        if goal is not None:
            box = cv2.boxPoints(goal)

            dist = depth_distance(box, depth_frame)

            if not np.isnan(dist):
                if (id == self.ID_PINK):
                    cv2.drawContours(self.pink_debug_mask,[np.int0(box)],0,(255,255,255),2)
                if (id == self.ID_BLUE):
                    cv2.drawContours(self.blue_debug_mask,[np.int0(box)],0,(255,255,255),2)

                x_center = np.mean([i[0] for i in box])
                y_center = np.mean([i[1] for i in box])
                dist /= 1000 #mm to m

                loc, dist_to_robot = calculateCoordinate(x_center, y_center, dist, mask.shape)
                loc = np.add(loc, self.goal_hack_const)

                # a dictionary with ids would be better
                if id is self.ID_PINK:
                    self.pink_location = (loc, dist_to_robot)
                    return self.pink_location
                if id is self.ID_BLUE:
                    self.blue_location = (loc, dist_to_robot)
                    return self.blue_location

        return None
