ut-robotics/picr21-team-kurgimopeed/(commit log)

2021-09-20 nuc led library
2021-09-20 Add wip flask backend, realsense camera feed
2021-09-27 Moved electronics from bitbucket to here
    [CPU.sch, Electronics.kicad_pcb, Electronics.sch]
2021-09-27 initial motor driver
2021-09-28 Updated and removed unnecessary resistors, removed cache
    [Electronics.sch]
2021-10-07 add functioning arrow key control, add nuc led status
2021-10-09 Reorganised schematics, added regulators
    [10118193-0001LF.step, CPU.sch, Driver.sch, Electronics.sch, Voltage regulator.sch]
2021-10-09 Added battery pads, documented voltage regulators
    [Voltage regulator.sch]
2021-10-18 fix BIG bug crash on file read/read, 2000post/s brrrrrrrr
    [ImageProcess.py, app.py]
2021-10-18 Added isolators, updated CPU pins
    [CPU.sch, Driver.sch, FTSH-105-XX-X-DV.step, Voltage regulator.sch]
2021-10-19 Added servo pins
2021-10-21 Added connectors, started relabeling pins
    [215079-4.step, CPU.sch, Connectors.sch, Driver.sch, Electronics.sch, Voltage regulator.sch]
2021-10-21 Another restructure, added CPU pins, updated V regulators
    [Connectors.sch, Driver.sch, Electronics.sch, LM3940IT-3.3.step, Voltage regulator.sch]
2021-10-21 LED fix
    [Connectors.sch]
2021-10-21 Updated titles
    [Connectors.sch, Driver.sch, Electronics.sch]
2021-10-23 Made things prettier, lowered logic 3v3 LDO back to 300mA
    [Connectors.sch, Driver.sch, Electronics.sch]
2021-10-23 Removed unnecessary files
    [CPU.sch, Voltage regulator.sch]
2021-10-23 Updated symbols
    [Connectors.sch, Driver.sch]
2021-10-23 Added reverse polarity protection
    [Connectors.sch]
2021-10-23 Added debug LEDs
    [Electronics.sch]
2021-10-23 Removed redundant comments
    [Electronics.sch]
2021-10-24 Various fixes, added ESD protection
    [Connectors.sch, Driver.sch]
2021-10-24 Remapped MCU
    [Electronics.sch]
2021-10-24 Updated rev numbers
    [Connectors.sch, Driver.sch, Electronics.sch]
2021-10-25 Replaced 5V regulator
    [Connectors.sch]
2021-10-25 MOSFET fix
    [Connectors.sch]
2021-10-26 Updated gitignore, switched out regulator
    [Connectors.sch]
2021-10-31 Attached footprints to components
    [Connectors.sch, Driver.sch, Electronics.kicad_pcb, Electronics.sch]
2021-11-01 Spurdo commit
    [Electronics.kicad_pcb, Electronics.sch, pcb_inner.dxf, pcb_outer.dxf]
2021-11-01 Added models to footprints
    [Electronics.kicad_pcb]
2021-11-01 Relocated libs, renamed MCU
    [Electronics.sch]
2021-11-01 Relocated 3d models
    [10118193-0001LF.step, 215079-4.step, FTSH-105-XX-X-DV.step, LM3940IT-3.3.step]
2021-11-01 Re-added footprints, removed excess model
    [Electronics.kicad_pcb, LM3940IT-3.3.step]
2021-11-01 Figured out how to automatically change date and revision
    [Connectors.sch, Driver.sch, Electronics.sch]
2021-11-01 Did the same to pcb
    [Electronics.kicad_pcb]
2021-11-02 Relocated items
    [Connectors.sch, Driver.sch, Electronics.kicad_pcb, Electronics.sch]
2021-11-02 Moved usb
    [Electronics.kicad_pcb, Electronics.sch]
2021-11-02 Sorting componenents on pcb
    [Driver.sch, Electronics.kicad_pcb]
2021-11-06 Fixed motor connectors, added vbat to 5v
    [Electronics.kicad_pcb]
2021-11-06 Great success
    [Electronics.kicad_pcb]
2021-11-07 Added MCU to main pcb
    [Electronics.kicad_pcb]
2021-11-07 Benis :DDDDDDDDDDDDDDDDDDDDD
    [Electronics.kicad_pcb]
2021-11-07 Removed 2 vias, added thermal vias
    [Electronics.kicad_pcb]
2021-11-07 Allahu akbar
    [Driver.sch, Electronics.kicad_pcb]
2021-11-07 Why are we still here? Just to suffer?
    [Electronics.kicad_pcb]
2021-11-08 BIG update (ball 3d location resolved 88))))
    [ArucoDetector.py, BallDetector.py, DrivingLogic.py, ImageProcess.py, app.py]
2021-11-09 Updated item locations
    [Connectors.sch, Electronics.kicad_pcb]
2021-11-11 Started drawing new traces
    [Electronics.kicad_pcb]
2021-11-16 Motor connections done
    [Electronics.kicad_pcb]
2021-11-16 MCU connections done v2
    [Electronics.kicad_pcb]
2021-11-16 Filled empty areas
    [Electronics.kicad_pcb]
2021-11-16 Rev2 Done?
    [Electronics.kicad_pcb]
2021-11-16 Added 3d model for inductor
    [B1047AS-4R7N=P3.step, Electronics.kicad_pcb]
2021-11-16 Updated rev and date
    [Electronics.kicad_pcb]
2021-11-16 Typo fix
    [Electronics.kicad_pcb]
2021-11-16 Fixus trace
    [Electronics.kicad_pcb]
2021-11-18 Spurdo v2.1 update
    [Electronics.kicad_pcb, Electronics.sch]
2021-11-18 Silk fixes
    [Electronics.kicad_pcb]
2021-11-20 Added vias
    [Electronics.kicad_pcb]
2021-11-20 Updated dates and rev nr
    [Electronics.kicad_pcb]
2021-11-21 Added BOM, gerber and drillhole files
    [Electronics-B_Cu.gbr, Electronics-B_Mask.gbr, Electronics-B_Paste.gbr, Electronics-B_SilkS.gbr, Electronics-Edge_Cuts.gbr, Electronics-F_Cu.gbr, Electronics-F_Mask.gbr, Electronics-F_Paste.gbr]
2021-11-22 Added schematic PDF
2021-12-16 treat stop as blocking importat data to send to motors
2022-01-01 CRC fixed, created an interfacing program
    [main.c, usb_test.py]
2022-01-03 fixed remote control delay and constant stopping
    [DrivingLogic.py]
2022-01-05 PWM works in debug, not in run
2022-01-13 Added PID control
2022-01-19 Change file mode, added ball interrupt
2022-01-24 tested all motors, added hold and angle servo, new music map, new mainboard comm
2022-01-24 no glue
2022-01-25 PID works, firmware done
2022-01-26 Complete failure, thank you, come again
    [DrivingLogic.py, RefereeClient.py, ThrowerTraining.py]
