ut-robotics/picr21-team-kurgimopeed/(notices)

Notices in the files:
firmware/Core/Src/main.c:
© Copyright (c) 2021 STMicroelectronics.
All rights reserved.
This software component is licensed by ST under BSD 3-Clause license,
the "License"; You may not use this file except in compliance with the
License. You may obtain a copy of the License at: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
electronics/3dmodels/FTSH-105-XX-X-DV.step:
FILE_NAME( 'e:/temp/worker_78/temp/exporttempdir_4168_61_aCrqb/format_0/FTSH-105-01-L-DV-K.stp', '2021-10-18T15:45:49', ( 'License CC BY-ND 4.0' ), ( 'CADENAS' ), ' ', 'PARTsolutions', ' ' );
parts and their libraries:
Copyright 2021 Accelerated Designs. All rights reserved.
